david11014/LutrarmyMic/README.md

# LutrarmyMic microphone circuit

# README.md
[English README.en.md](README.en.md)

[繁體中文 README.zh-Hans.md](README.zh-Hans.md)
