david11014/LutrarmyMic/img/BatPwr.png

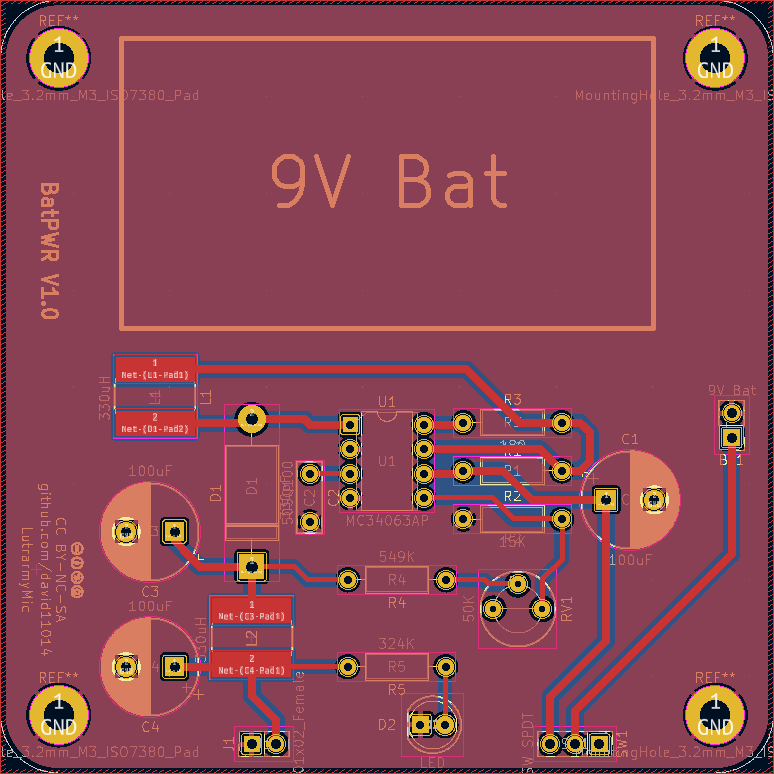
img/BatPwr.png
