david11014/LutrarmyMic/img/block.png

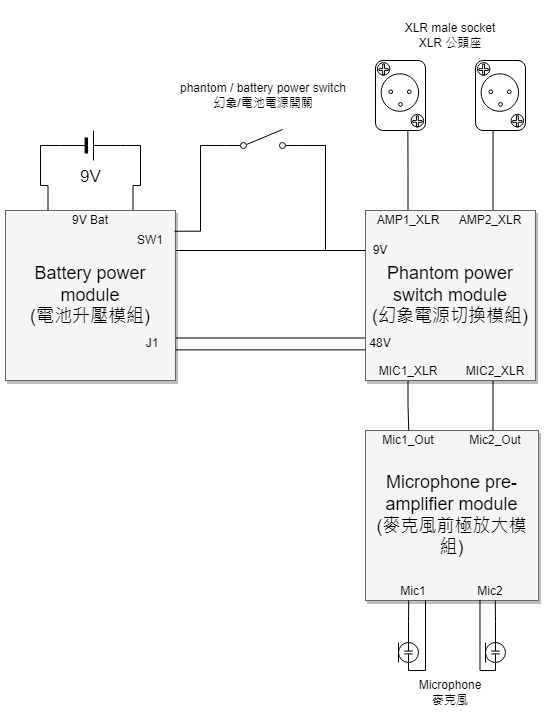
img/block.png
