david11014/LutrarmyMic/img/PhPwrSwitch.png

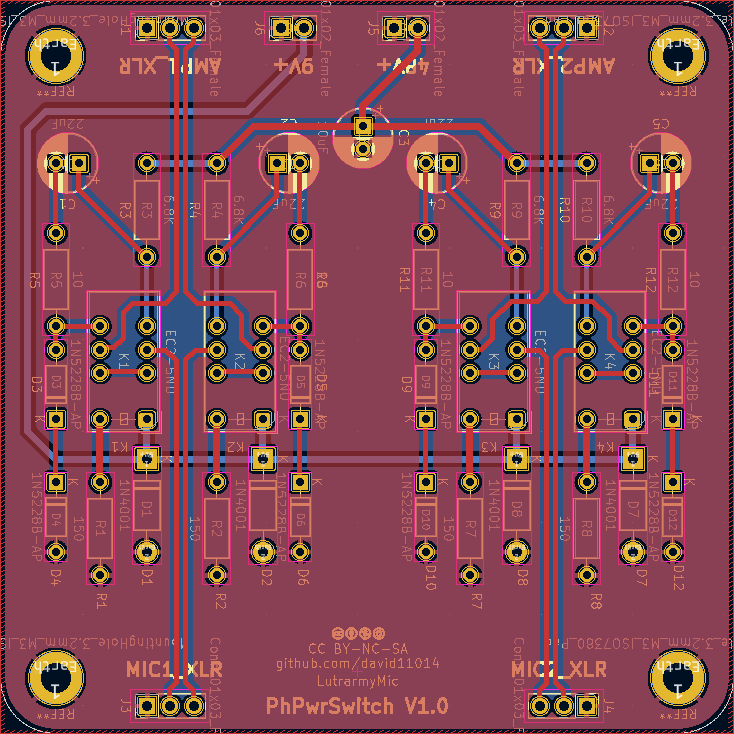
img/PhPwrSwitch.png
