david11014/LutrarmyMic/img/PreAmp.png

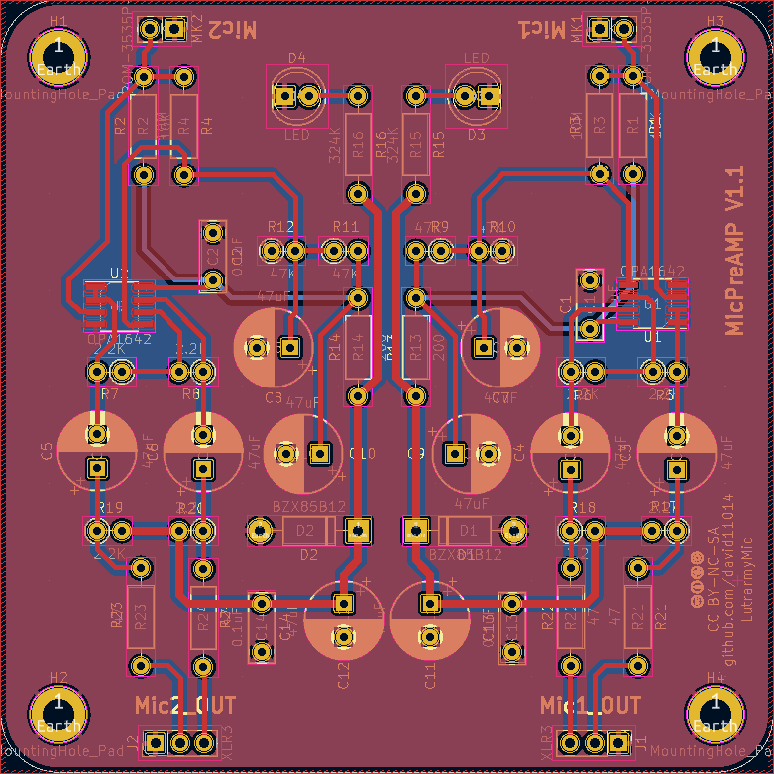
img/PreAmp.png
