david11014/LutrarmyMic/LutrarmyMic_PreAmp/LutrarmyMic_PreAmp.kicad_pcb

## KiCad design LutrarmyMic_PreAmp/LutrarmyMic_PreAmp.kicad_pcb (2023-04-16)

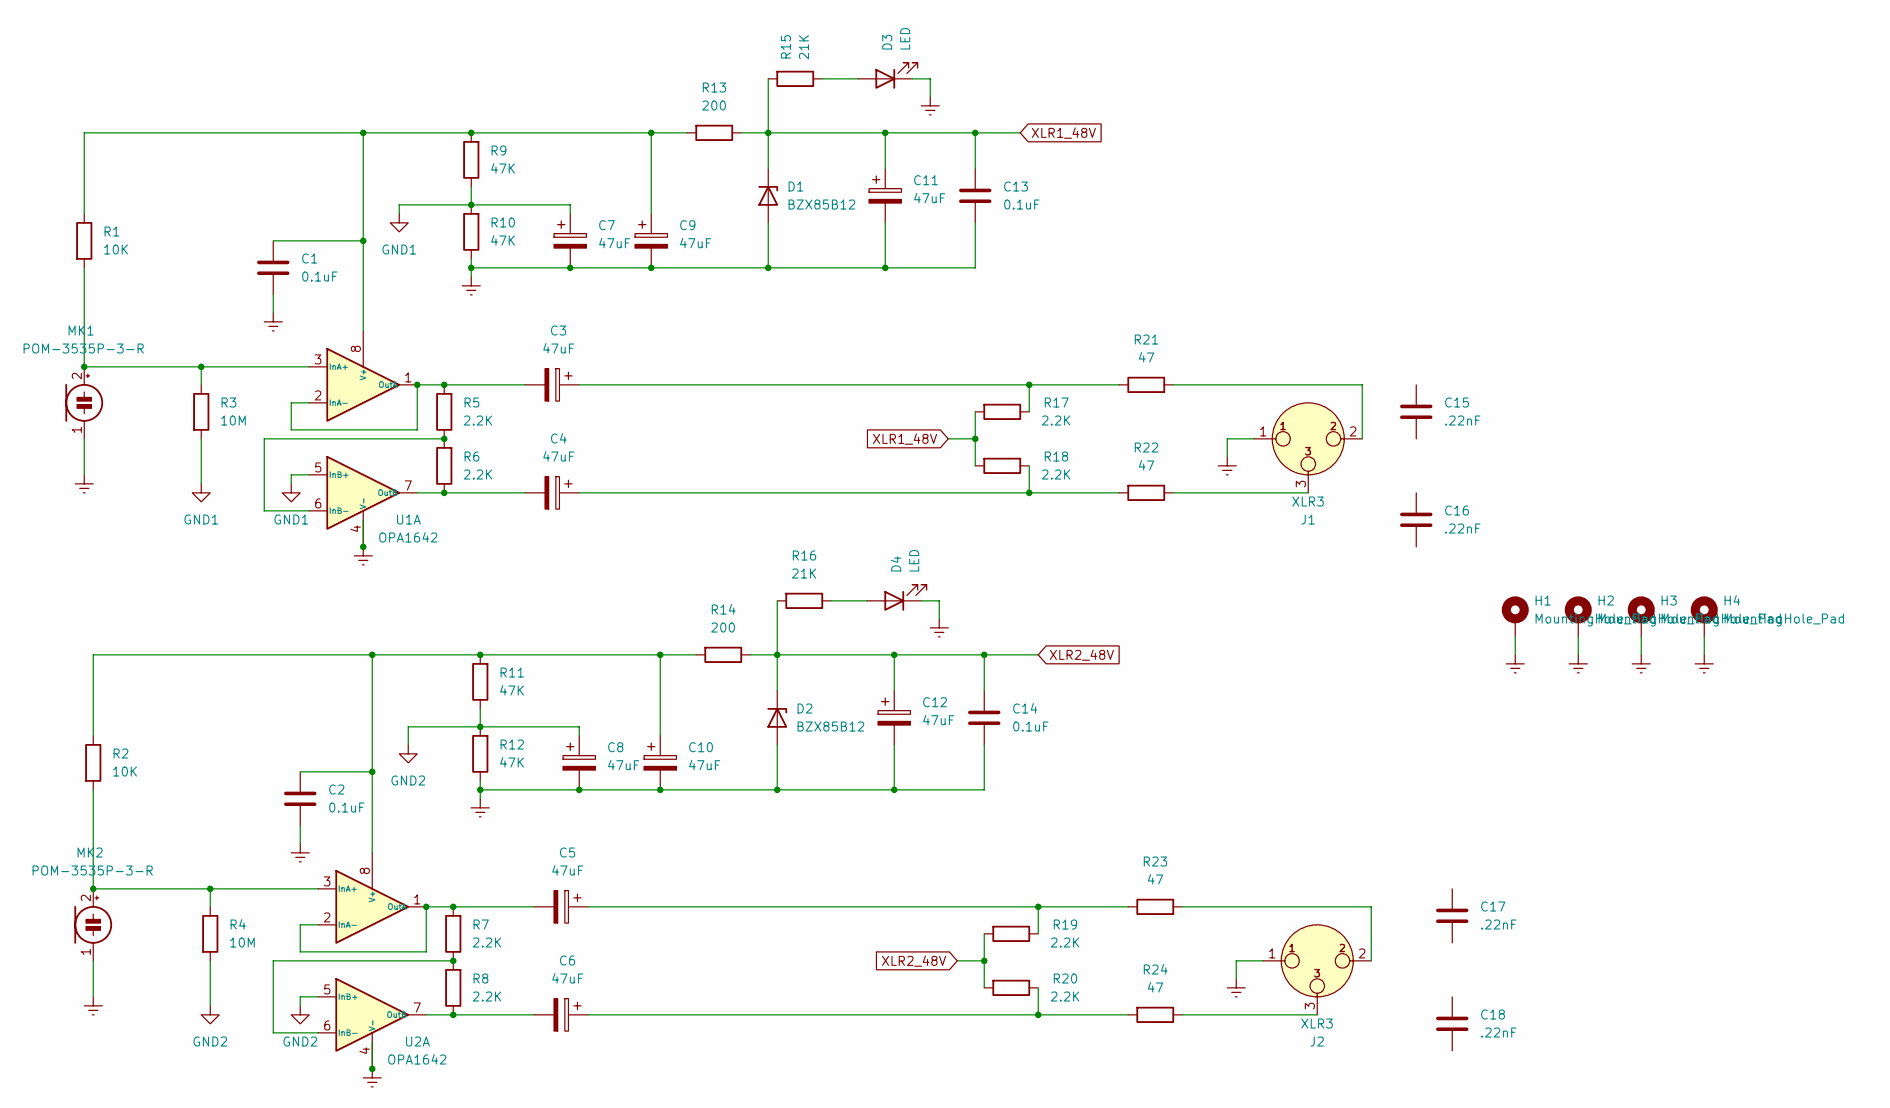
[picture p5: schematic LutrarmyMic_PreAmp.kicad_sch]

Parts:
C1, C2, C13, C14: 0.1uF; C_Rect_L7.2mm_W2.5mm_P5.00mm_FKS2_FKP2_MKS2_MKP2
C3, C4, C5, C6, C7, C8, C9, C10, C11, C12: 47uF; CP_Radial_D8.0mm_P3.50mm
C15, C16, C17, C18: .22nF; C_Rect_L7.2mm_W2.5mm_P5.00mm_FKS2_FKP2_MKS2_MKP2
D1, D2: BZX85B12; D_DO-41_SOD81_P10.16mm_Horizontal
D3, D4: LED; LED_D5.0mm_Clear
H1, H2, H3, H4: MountingHole_Pad; MountingHole_3.2mm_M3_DIN965_Pad
J1, J2: XLR3; PinHeader_1x03_P2.54mm_Vertical
MK1, MK2: POM-3535P-3-R; PinHeader_1x02_P2.54mm_Vertical
R1, R2: 10K; R_Axial_DIN0207_L6.3mm_D2.5mm_P10.16mm_Horizontal
R3, R4: 10M; R_Axial_DIN0207_L6.3mm_D2.5mm_P10.16mm_Horizontal
R5, R6, R7, R8, R17, R18, R19, R20: 2.2K; R_Axial_DIN0207_L6.3mm_D2.5mm_P2.54mm_Vertical
R9, R10, R11, R12: 47K; R_Axial_DIN0207_L6.3mm_D2.5mm_P2.54mm_Vertical
R13, R14: 200; R_Axial_DIN0207_L6.3mm_D2.5mm_P10.16mm_Horizontal
R15, R16: 21K; R_Axial_DIN0207_L6.3mm_D2.5mm_P10.16mm_Horizontal
R21, R22, R23, R24: 47; R_Axial_DIN0207_L6.3mm_D2.5mm_P10.16mm_Horizontal
U1, U2: OPA1642; SOIC-8_3.9x4.9mm_P1.27mm

Connections:
Earth: C1.2, C2.2, C7.2, C8.2, C9.2, C10.2, C11.2, C12.2, C13.2, C14.2, D1.2 (A), D2.2 (A), D3.1 (K), D4.1 (K), H1.1, H2.1, H3.1, H4.1, J1.1, J2.1, MK1.1 (-), MK2.1 (-), R10.1, R12.1, U1.4 (V-), U2.4 (V-)
GND1: C7.1, R3.2, R9.1, R10.2, U1.5 (InB+)
GND2: C8.1, R4.2, R11.1, R12.2, U2.5 (InB+)
unnamed: C1.1, C9.1, R1.1, R9.2, R13.2, U1.8 (V+)
unnamed: C3.1, R17.1, R21.1
unnamed: C3.2, R5.2, U1.1 (OutA), U1.2 (InA-)
unnamed: C4.1, R18.1, R22.2
unnamed: C4.2, R6.1, U1.7 (OutB)
unnamed: C5.1, R19.1, R23.1
unnamed: C5.2, R7.2, U2.1 (OutA), U2.2 (InA-)
unnamed: C6.1, R20.1, R24.2
unnamed: C6.2, R8.1, U2.7 (OutB)
unnamed: C2.1, C10.1, R2.1, R11.2, R14.2, U2.8 (V+)
unnamed: D3.2 (A), R15.1
unnamed: D4.2 (A), R16.1
unnamed: J1.2, R21.2
unnamed: J1.3, R22.1
unnamed: J2.2, R23.2
unnamed: J2.3, R24.1
unnamed: MK1.2 (+), R1.2, R3.1, U1.3 (InA+)
unnamed: MK2.2 (+), R2.2, R4.1, U2.3 (InA+)
unnamed: R5.1, R6.2, U1.6 (InB-)
unnamed: R7.1, R8.2, U2.6 (InB-)
XLR1_48V: C11.1, C13.1, D1.1 (K), R13.1, R15.2, R17.2, R18.2
XLR2_48V: C12.1, C14.1, D2.1 (K), R14.1, R16.2, R19.2, R20.2

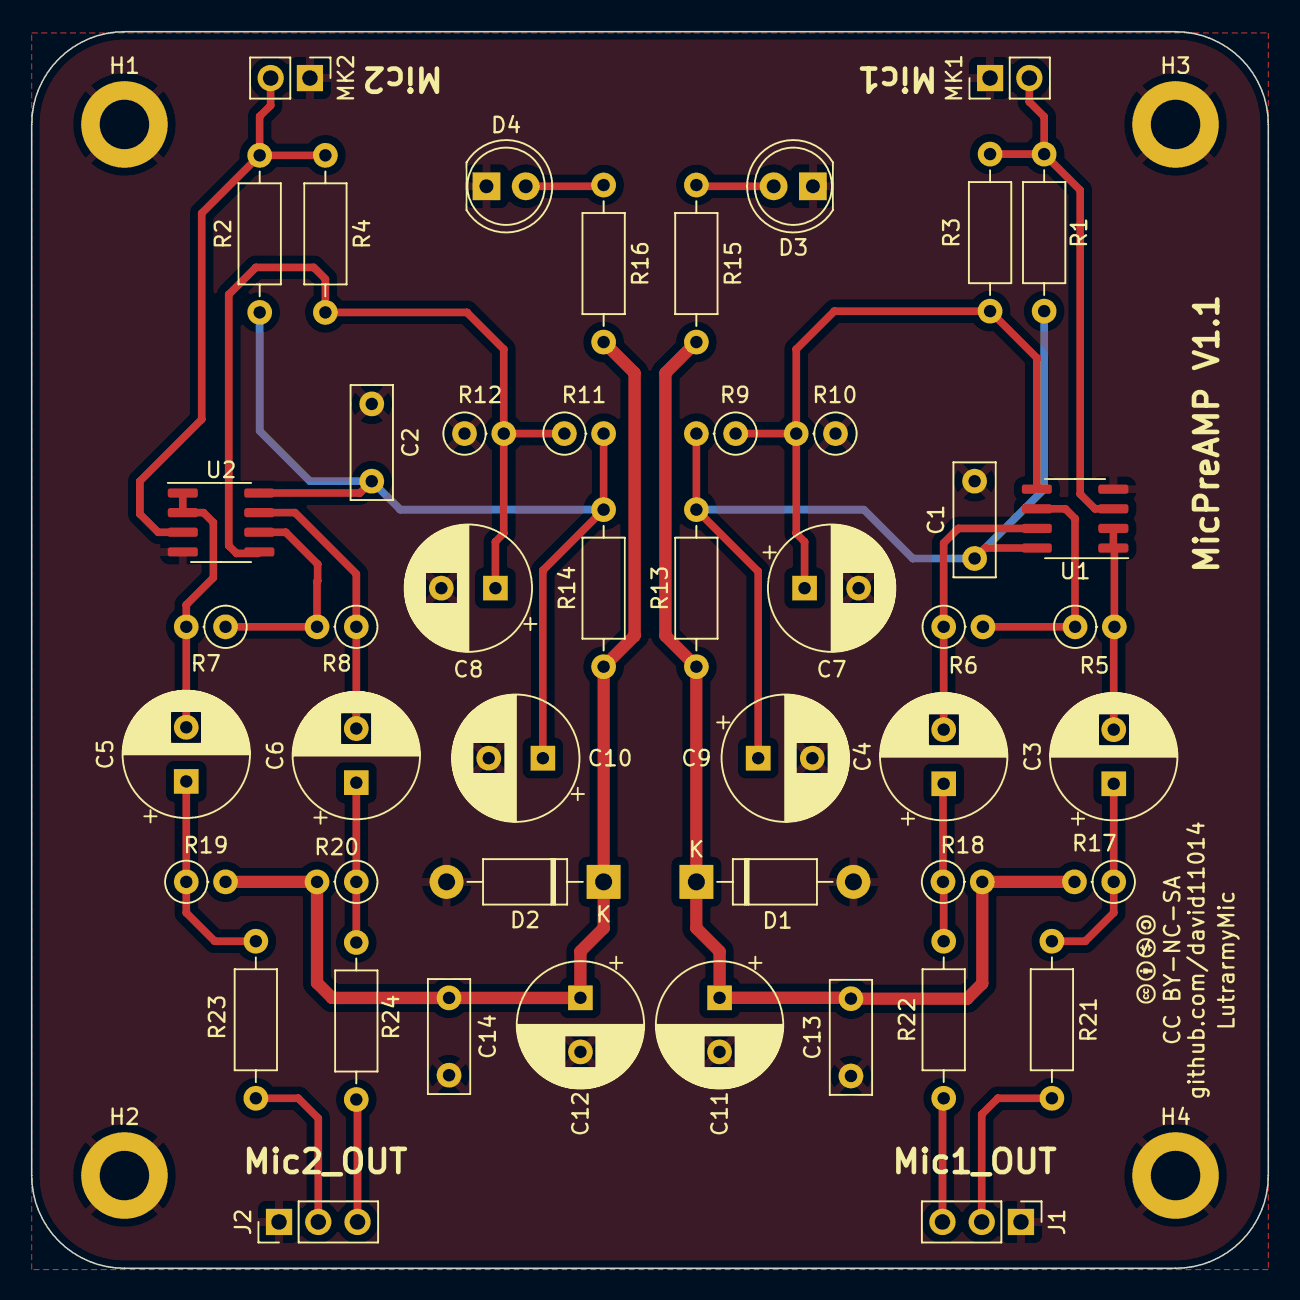
[picture p6: board LutrarmyMic_PreAmp.kicad_pcb from above]

Board: 2 copper layers, 80.0 x 80.0 mm, 53 parts (0 on the bottom side), 25 nets.

Other parts of the board:
LutrarmyMic: CC-BY-NC-SA
