david11014/LutrarmyMic/LutrarmyMic_PhPwrSwitch/LutrarmyMic_PhPwrSwitch.kicad_pcb

## KiCad design LutrarmyMic_PhPwrSwitch/LutrarmyMic_PhPwrSwitch.kicad_pcb (2023-02-25)

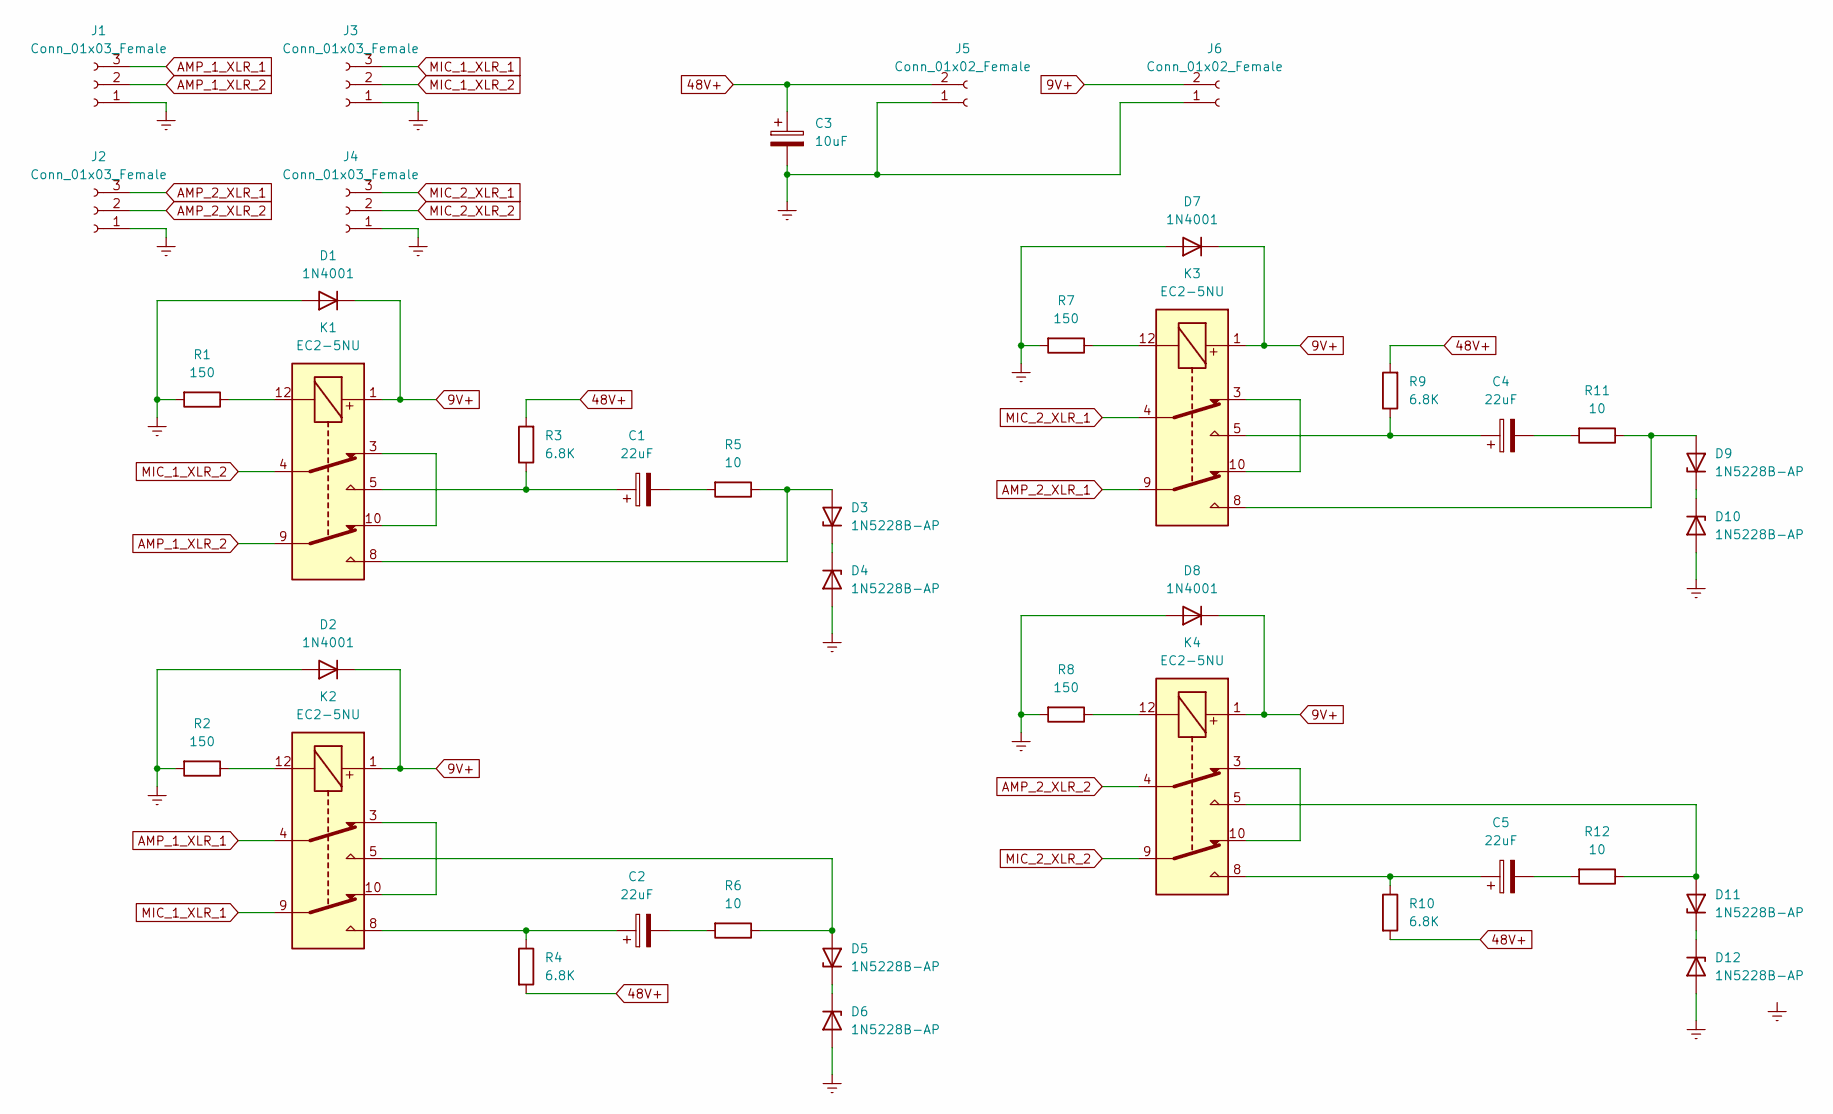
[picture p7: schematic LutrarmyMic_PhPwrSwitch.kicad_sch]

Parts:
C1, C2, C4, C5: 22uF; CP_Radial_D6.3mm_P2.50mm
C3: 10uF; CP_Radial_D6.3mm_P2.50mm
D1, D2, D7, D8: 1N4001; D_DO-41_SOD81_P10.16mm_Horizontal
D3, D4, D5, D6, D9, D10, D11, D12: 1N5228B-AP; D_DO-35_SOD27_P7.62mm_Horizontal
J1, J2, J3, J4: Conn_01x03_Female; PinHeader_1x03_P2.54mm_Vertical
J5, J6: Conn_01x02_Female; PinHeader_1x02_P2.54mm_Vertical
K1, K2, K3, K4: EC2-5NU; Relay_DPDT_Kemet_EC2
R1, R2, R7, R8: 150; R_Axial_DIN0207_L6.3mm_D2.5mm_P10.16mm_Horizontal
R3, R4, R9, R10: 6.8K; R_Axial_DIN0207_L6.3mm_D2.5mm_P10.16mm_Horizontal
R5, R6, R11, R12: 10; R_Axial_DIN0207_L6.3mm_D2.5mm_P10.16mm_Horizontal

Connections:
9V+: D1.1 (K), D2.1 (K), D7.1 (K), D8.1 (K), J6.2, K1.1, K2.1, K3.1, K4.1
48V+: C3.1, J5.2, R3.2, R4.2, R9.2, R10.2
AMP_1_XLR_1: J1.3, K2.4
AMP_1_XLR_2: J1.2, K1.9
AMP_2_XLR_1: J2.3, K3.9
AMP_2_XLR_2: J2.2, K4.4
Earth: C3.2, D1.2 (A), D2.2 (A), D4.2 (A), D6.2 (A), D7.2 (A), D8.2 (A), D10.2 (A), D12.2 (A), J1.1, J2.1, J3.1, J4.1, J5.1, J6.1, R1.2, R2.2, R7.2, R8.2
MIC_1_XLR_1: J3.3, K2.9
MIC_1_XLR_2: J3.2, K1.4
MIC_2_XLR_1: J4.3, K3.4
MIC_2_XLR_2: J4.2, K4.9
unnamed: C1.1, K1.5, R3.1
unnamed: C1.2, R5.2
unnamed: C2.1, K2.8, R4.1
unnamed: C2.2, R6.2
unnamed: C4.1, K3.5, R9.1
unnamed: C4.2, R11.2
unnamed: C5.1, K4.8, R10.1
unnamed: C5.2, R12.2
unnamed: D3.1 (K), D4.1 (K)
unnamed: D3.2 (A), K1.8, R5.1
unnamed: D5.1 (K), D6.1 (K)
unnamed: D5.2 (A), K2.5, R6.1
unnamed: D9.2 (A), K3.8, R11.1
unnamed: D9.1 (K), D10.1 (K)
unnamed: D11.1 (K), D12.1 (K)
unnamed: D11.2 (A), K4.5, R12.1
unnamed: K1.3, K1.10
unnamed: K1.12, R1.1
unnamed: K2.3, K2.10
unnamed: K2.12, R2.1
unnamed: K3.3, K3.10
unnamed: K3.12, R7.1
unnamed: K4.3, K4.10
unnamed: K4.12, R8.1

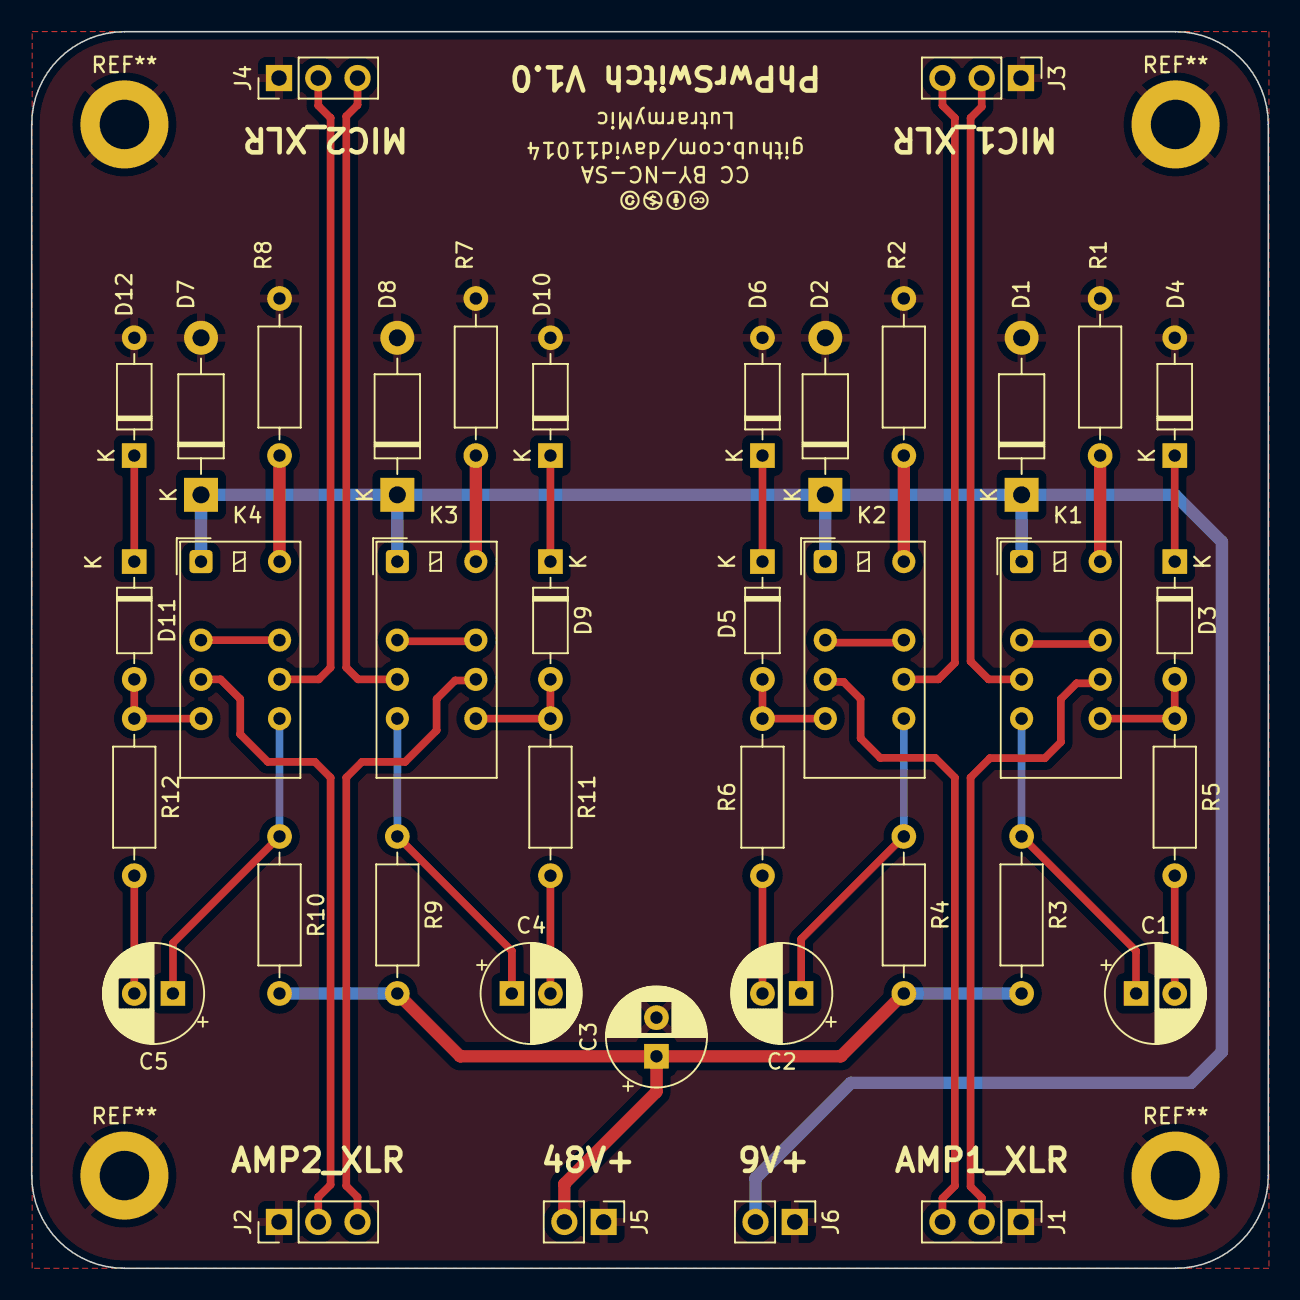
[picture p8: board LutrarmyMic_PhPwrSwitch.kicad_pcb from above]

Board: 2 copper layers, 80.0 x 80.0 mm, 40 parts (0 on the bottom side), 35 nets.

Other parts of the board:
LutrarmyMic: CC-BY-NC-SA
