david11014/LutrarmyMic/LutrarmyMic_BatPwr/LutrarmyMic_BatPwr.kicad_pcb

## KiCad design LutrarmyMic_BatPwr/LutrarmyMic_BatPwr.kicad_pcb (2023-02-25)

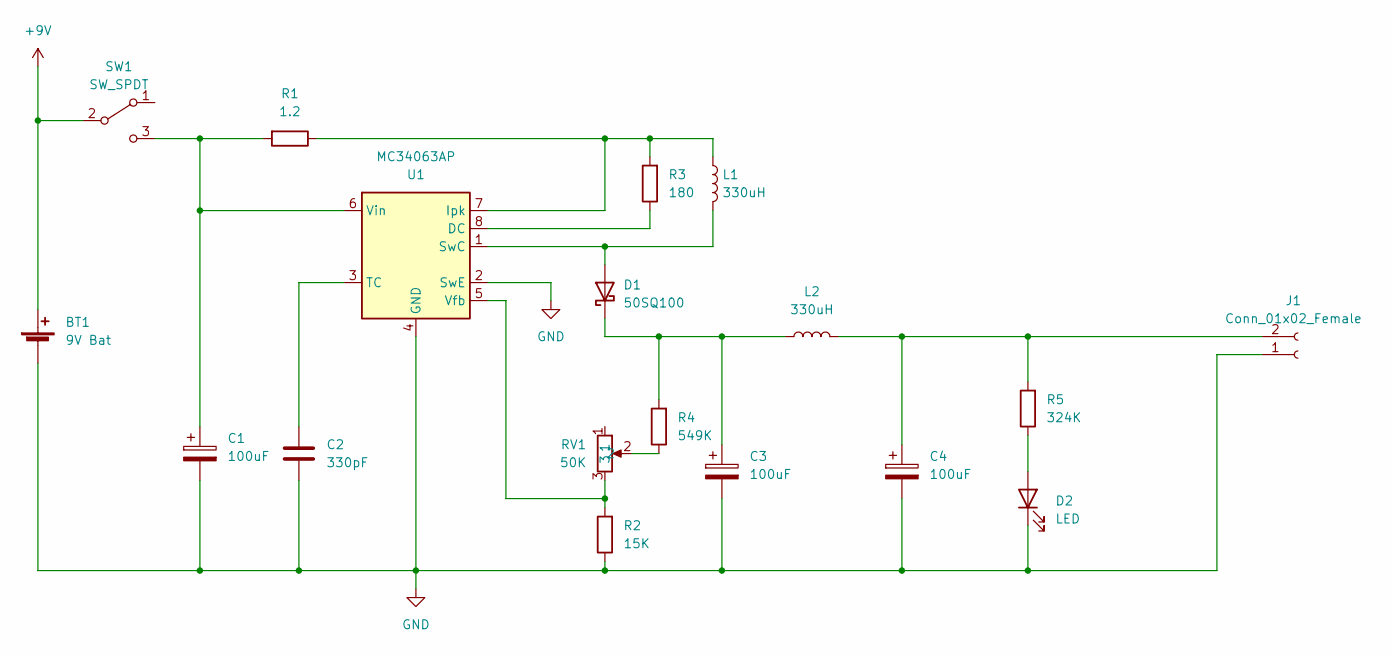
[picture p9: schematic LutrarmyMic_BatPwr.kicad_sch]

Parts:
BT1: 9V Bat; PinHeader_1x02_P2.54mm_Vertical
C1, C3, C4: 100uF; CP_Radial_D10.0mm_P5.00mm
C2: 330pF; C_Rect_L7.2mm_W2.5mm_P5.00mm_FKS2_FKP2_MKS2_MKP2
D1: 50SQ100; D_DO-201_P15.24mm_Horizontal
D2: LED; LED_D5.0mm_Clear
J1: Conn_01x02_Female; PinHeader_1x02_P2.54mm_Vertical
L1, L2: 330uH; L_Bourns-SRN8040_8x8.15mm
R1: 1.2; R_Axial_DIN0207_L6.3mm_D2.5mm_P10.16mm_Horizontal
R2: 15K; R_Axial_DIN0207_L6.3mm_D2.5mm_P10.16mm_Horizontal
R3: 180; R_Axial_DIN0207_L6.3mm_D2.5mm_P10.16mm_Horizontal
R4: 549K; R_Axial_DIN0207_L6.3mm_D2.5mm_P10.16mm_Horizontal
R5: 324K; R_Axial_DIN0207_L6.3mm_D2.5mm_P10.16mm_Horizontal
RV1: 50K; Potentiometer_Bourns_3339P_Vertical_HandSoldering
SW1: SW_SPDT; PinHeader_1x03_P2.54mm_Vertical
U1: MC34063AP; DIP-8_W7.62mm

Connections:
+9V: BT1.1 (+), SW1.2 (B)
GND: BT1.2 (-), C1.2, C2.2, C3.2, C4.2, D2.1 (K), J1.1, R2.1, U1.2 (SwE), U1.4 (GND)
unnamed: C1.1, R1.2, SW1.3 (C), U1.6 (Vin)
unnamed: C2.1, U1.3 (TC)
unnamed: C3.1, D1.1 (K), L2.1, R4.2
unnamed: C4.1, J1.2, L2.2, R5.2
unnamed: D1.2 (A), L1.2, U1.1 (SwC)
unnamed: D2.2 (A), R5.1
unnamed: L1.1, R1.1, R3.2, U1.7 (Ipk)
unnamed: R2.2, RV1.3, U1.5 (Vfb)
unnamed: R3.1, U1.8 (DC)
unnamed: R4.1, RV1.2

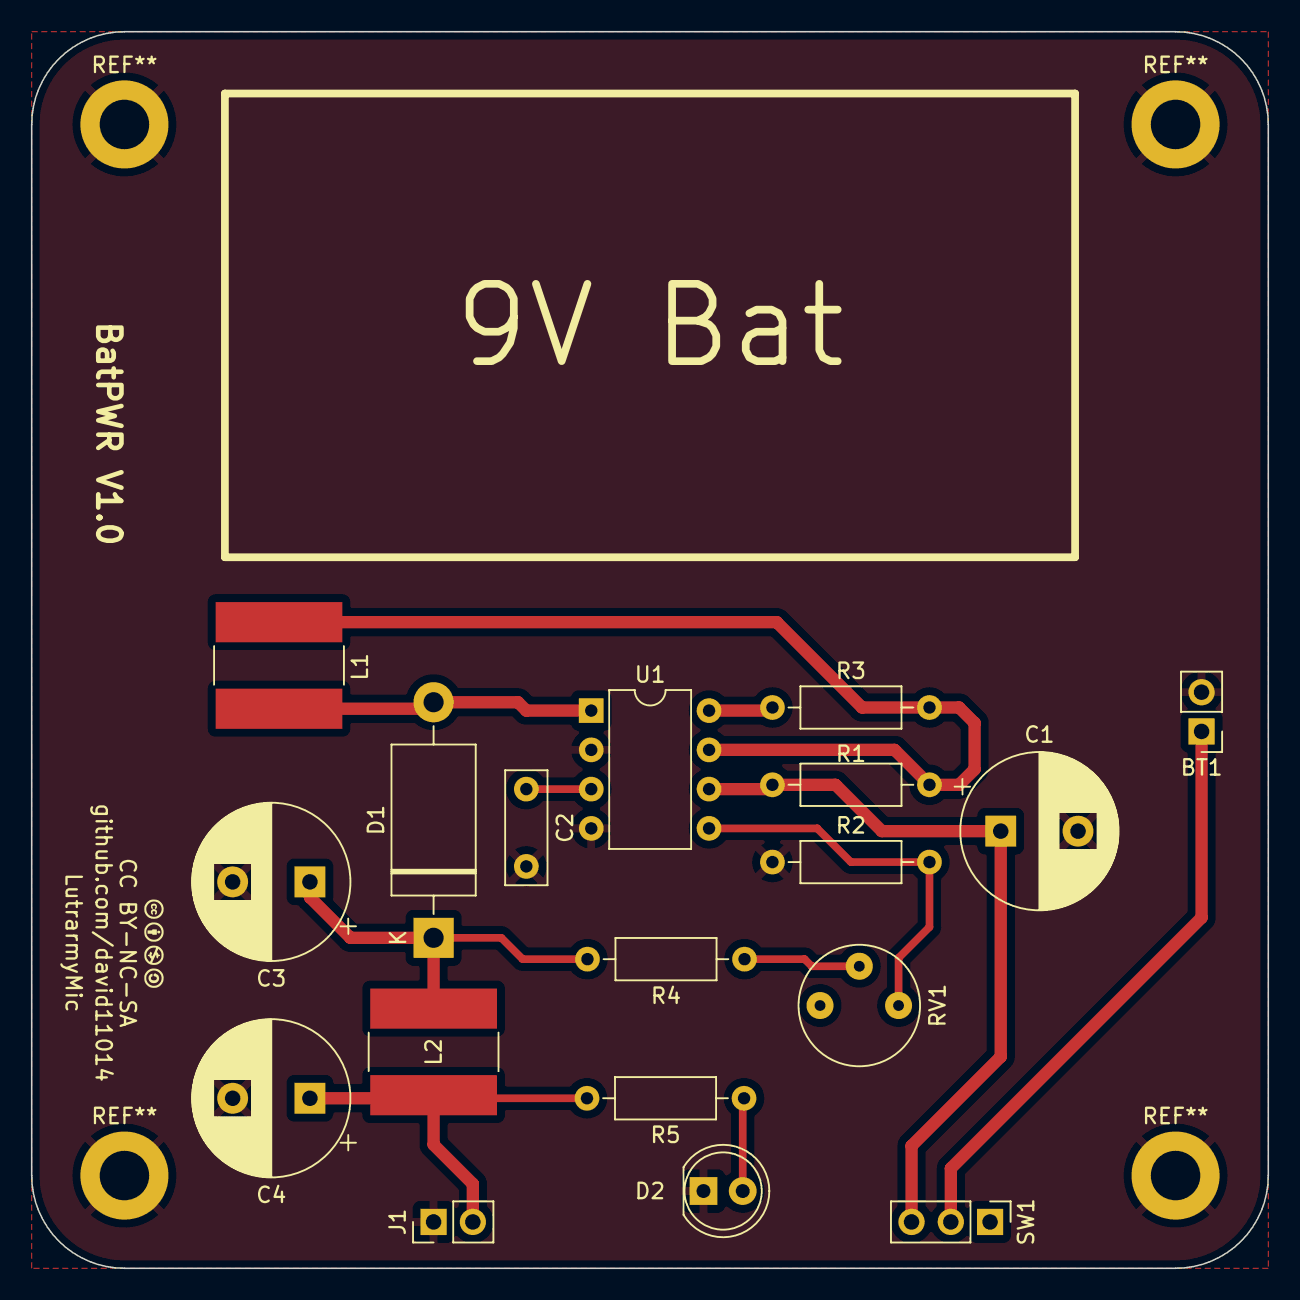
[picture p10: board LutrarmyMic_BatPwr.kicad_pcb from above]

Board: 2 copper layers, 80.0 x 80.0 mm, 19 parts (0 on the bottom side), 12 nets.

Other parts of the board:
LutrarmyMic: CC-BY-NC-SA
