david11014/LutrarmyMic/(commit log)

2023-02-25 [Add] Add Battery power board
    [LutrarmyMic_BatPwr.kicad_pcb, LutrarmyMic_BatPwr.kicad_sch]
2023-02-25 [Add] Add phantom power switch board
    [LutrarmyMic_PhPwrSwitch.kicad_pcb, LutrarmyMic_PhPwrSwitch.kicad_sch]
2023-02-25 [Add] Add Mic pre amp board
    [LutrarmyMic_PreAmp.kicad_pcb, LutrarmyMic_PreAmp.kicad_sch]
2023-02-25 [Add] Add gbr and drill file
    [LutrarmyMic_BatPwr-B_Cu.gbr, LutrarmyMic_BatPwr-B_Mask.gbr, LutrarmyMic_BatPwr-B_Paste.gbr, LutrarmyMic_BatPwr-B_Silkscreen.gbr, LutrarmyMic_BatPwr-Edge_Cuts.gbr, LutrarmyMic_BatPwr-F_Cu.gbr, LutrarmyMic_BatPwr-F_Mask.gbr, LutrarmyMic_BatPwr-F_Paste.gbr]
2023-02-25 [move] Move file location
    [LutrarmyMic_PhPwrSwitch-B_Cu.gbr, LutrarmyMic_PhPwrSwitch-B_Mask.gbr, LutrarmyMic_PhPwrSwitch-B_Paste.gbr, LutrarmyMic_PhPwrSwitch-B_Silkscreen.gbr, LutrarmyMic_PhPwrSwitch-Edge_Cuts.gbr, LutrarmyMic_PhPwrSwitch-F_Cu.gbr, LutrarmyMic_PhPwrSwitch-F_Mask.gbr, LutrarmyMic_PhPwrSwitch-F_Paste.gbr]
2023-02-25 [fix] modify text orientation
    [LutrarmyMic_PhPwrSwitch-B_Cu.gbr, LutrarmyMic_PhPwrSwitch-B_Mask.gbr, LutrarmyMic_PhPwrSwitch-B_Paste.gbr, LutrarmyMic_PhPwrSwitch-B_Silkscreen.gbr, LutrarmyMic_PhPwrSwitch-Edge_Cuts.gbr, LutrarmyMic_PhPwrSwitch-F_Cu.gbr, LutrarmyMic_PhPwrSwitch-F_Mask.gbr, LutrarmyMic_PhPwrSwitch-F_Paste.gbr]
2023-04-16 更新最終版 gbr
    [LutrarmyMic_Full.kicad_pcb, LutrarmyMic_Full.kicad_sch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]
2023-05-01 [更新] 更新說明書
